chiskas2/333-RGB-LED-MiniCube/333 RGB LED minicube schematics.pdf

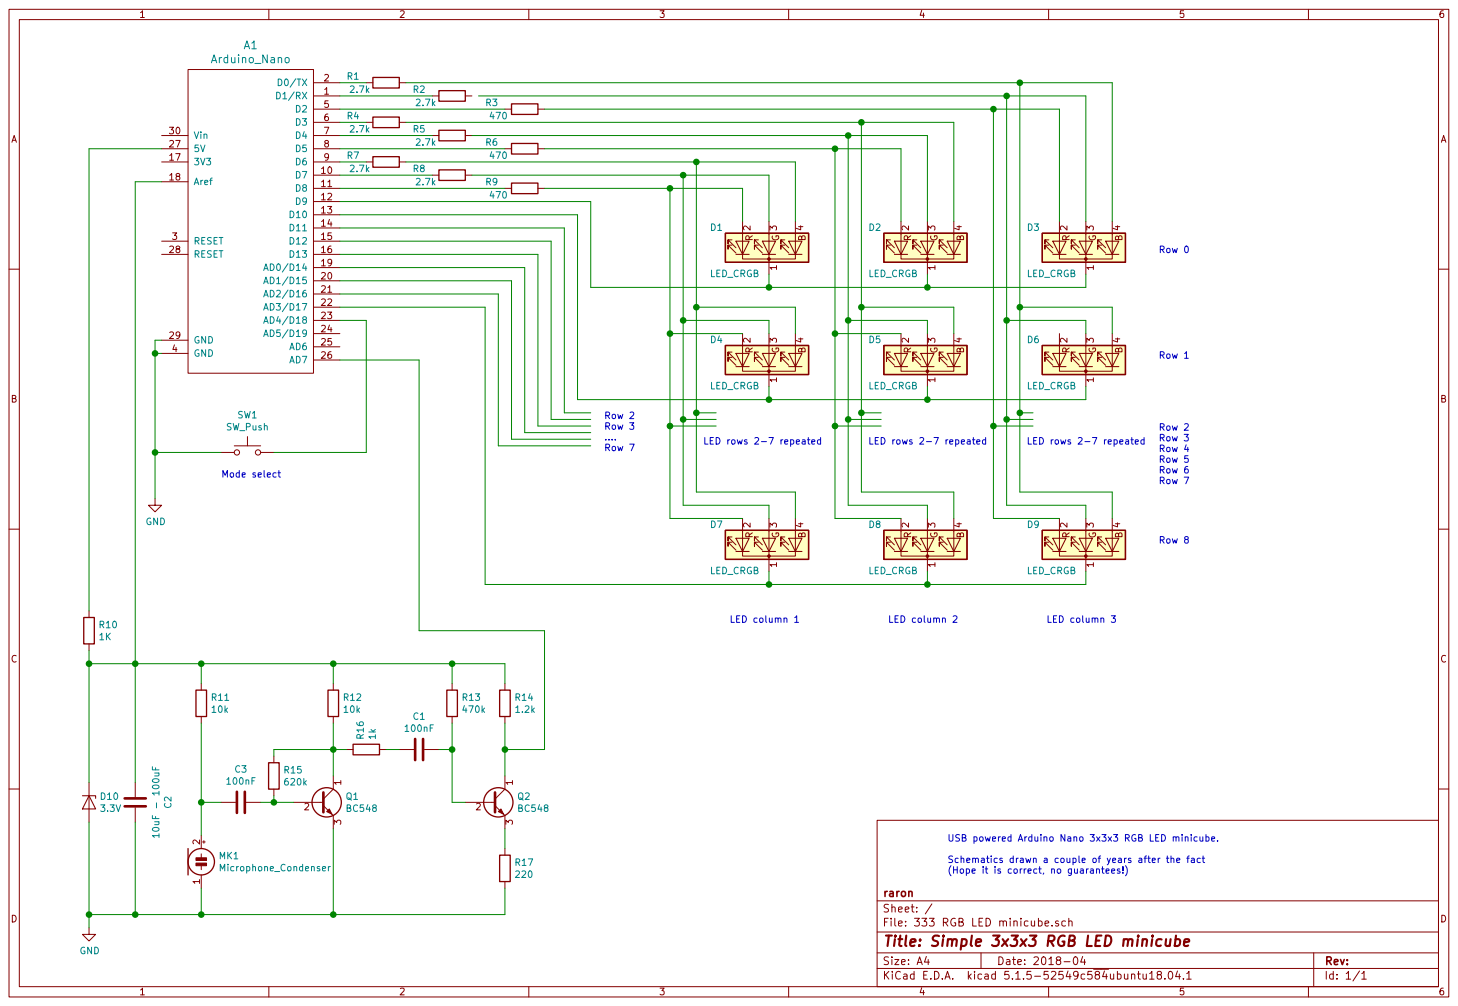
[picture p1: page 1]

USB powered Arduino Nano 3x3x3 RGB LED minicube.

Schematics drawn a couple of years after the fact

Id: 1/1 Title: Simple 3x3x3 RGB LED minicube
