chiskas2/333-RGB-LED-MiniCube/(commit log)

2020-04-07 Schematics added (pdf)
2020-04-14 Add files via upload
    Just renamed to include "schematics" in the name
2020-04-14 Update README.md
    Fixed Atmega datasheet reference.
    Procrastinated some LED cube building tips.
2020-04-14 Update README.md
    Procrastinatingly added more stuff.
    - fixed Atmega datasheet reference
    - added build LED cube tips
